cdntinker/Volt-Picker/3D/VoltPicker Case.FCStd

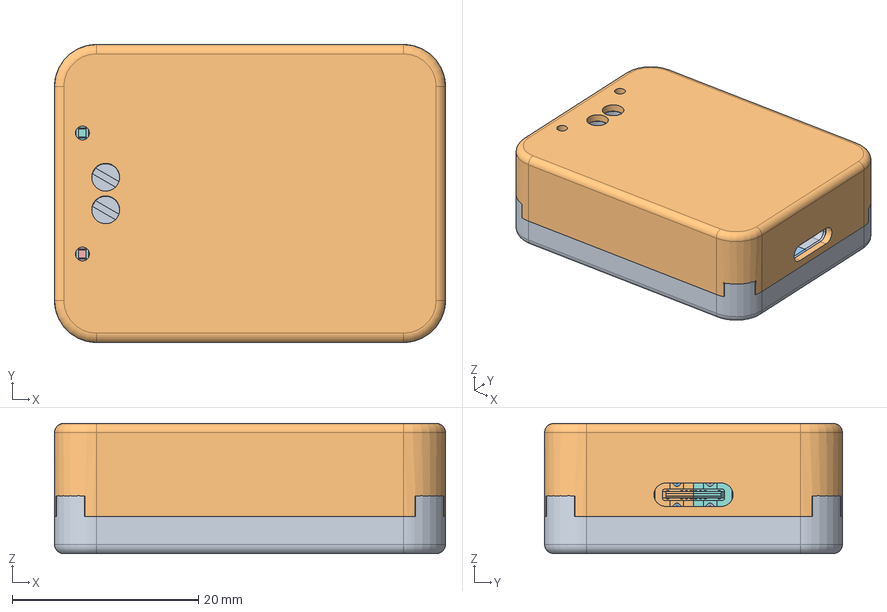
[picture p3: CAD file, 2026-10-18]
3D/VoltPicker Case.FCStd
42.0 x 32.0 x 14.0 mm
Bottom001
Top001
R_0603_1608Metric
R_0603_1608Metric001
R_1206_3216Metric
TDFN-14_L3.0-W3.0-P0.40-TL-EP.new
R_0603_1608Metric002
LED_0603_1608Metric
POWERPAK-1212-8_L3.1-W3.1-P0.65-LS3.3-BL
R_0603_1608Metric003
R_0603_1608Metric004
C_0805_2012Metric
R_0603_1608Metric005
R_0603_1608Metric006
solidBody
solidLead
solidLead001
C_0603_1608Metric
R_0603_1608Metric007
solidBody001
solidLead003
solidLead004
R_0603_1608Metric008
C_0805_2012Metric001
DG350-3.5-2P001
R_0603_1608Metric009
POWERPAK-1212-8_L3.1-W3.1-P0.65-LS3.3-BL001
R_0603_1608Metric010
R_0603_1608Metric011
R_0603_1608Metric012
R_0603_1608Metric013
USB_C_Receptacle_GCT_USB4105-xx-A_16P_TopMnt_Horizontal
USB_C_Receptacle_GCT_USB4105-xx-A_16P_TopMnt_Horizontal001
USB_C_Receptacle_GCT_USB4105-xx-A_16P_TopMnt_Horizontal002
USB_C_Receptacle_GCT_USB4105-xx-A_16P_TopMnt_Horizontal003
USB_C_Receptacle_GCT_USB4105-xx-A_16P_TopMnt_Horizontal004
USB_C_Receptacle_GCT_USB4105-xx-A_16P_TopMnt_Horizontal005
USB_C_Receptacle_GCT_USB4105-xx-A_16P_TopMnt_Horizontal006
USB_C_Receptacle_GCT_USB4105-xx-A_16P_TopMnt_Horizontal007
USB_C_Receptacle_GCT_USB4105-xx-A_16P_TopMnt_Horizontal008
USB_C_Receptacle_GCT_USB4105-xx-A_16P_TopMnt_Horizontal009
USB_C_Receptacle_GCT_USB4105-xx-A_16P_TopMnt_Horizontal010
USB_C_Receptacle_GCT_USB4105-xx-A_16P_TopMnt_Horizontal011
USB_C_Receptacle_GCT_USB4105-xx-A_16P_TopMnt_Horizontal012
USB_C_Receptacle_GCT_USB4105-xx-A_16P_TopMnt_Horizontal013
USB_C_Receptacle_GCT_USB4105-xx-A_16P_TopMnt_Horizontal014
USB_C_Receptacle_GCT_USB4105-xx-A_16P_TopMnt_Horizontal015
USB_C_Receptacle_GCT_USB4105-xx-A_16P_TopMnt_Horizontal016
USB_C_Receptacle_GCT_USB4105-xx-A_16P_TopMnt_Horizontal017
USB_C_Receptacle_GCT_USB4105-xx-A_16P_TopMnt_Horizontal018
USB_C_Receptacle_GCT_USB4105-xx-A_16P_TopMnt_Horizontal019
USB_C_Receptacle_GCT_USB4105-xx-A_16P_TopMnt_Horizontal020
USB_C_Receptacle_GCT_USB4105-xx-A_16P_TopMnt_Horizontal021
USB_C_Receptacle_GCT_USB4105-xx-A_16P_TopMnt_Horizontal022
USB_C_Receptacle_GCT_USB4105-xx-A_16P_TopMnt_Horizontal023
USB_C_Receptacle_GCT_USB4105-xx-A_16P_TopMnt_Horizontal024
USB_C_Receptacle_GCT_USB4105-xx-A_16P_TopMnt_Horizontal025
USB_C_Receptacle_GCT_USB4105-xx-A_16P_TopMnt_Horizontal026
USB_C_Receptacle_GCT_USB4105-xx-A_16P_TopMnt_Horizontal027
USB_C_Receptacle_GCT_USB4105-xx-A_16P_TopMnt_Horizontal028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
