cdntinker/Volt-Picker/Hardware/KiCAD_Customs/3D/LittleFuse-154.step

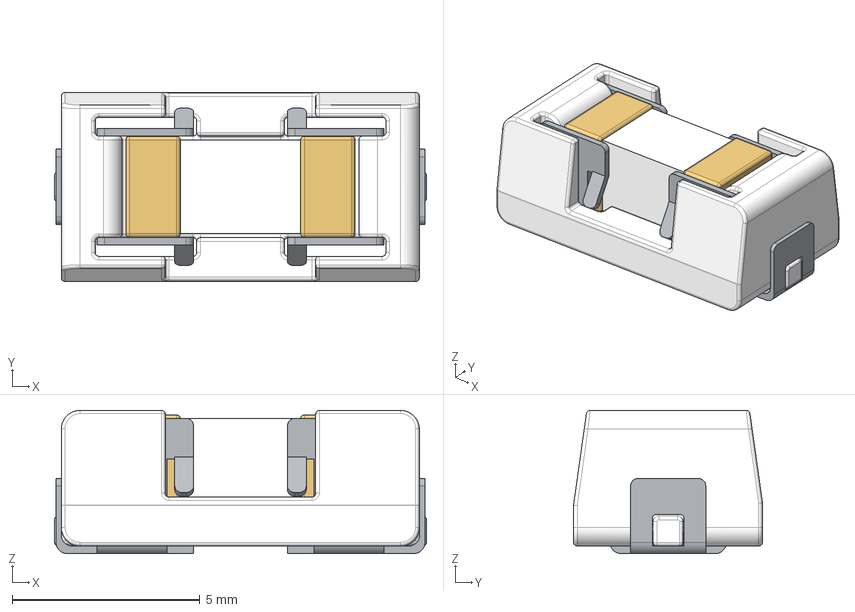
[picture p4: CAD file, 2026-10-17]
Hardware/KiCAD_Customs/3D/LittleFuse-154.step
9.90 x 5.03 x 3.81 mm
Lead2
Lead1
plastic bit
