cdntinker/Volt-Picker/Hardware/KiCAD_Customs/C24735840/TDFN-14_L3.0-W3.0-P0.40-TL-EP.step

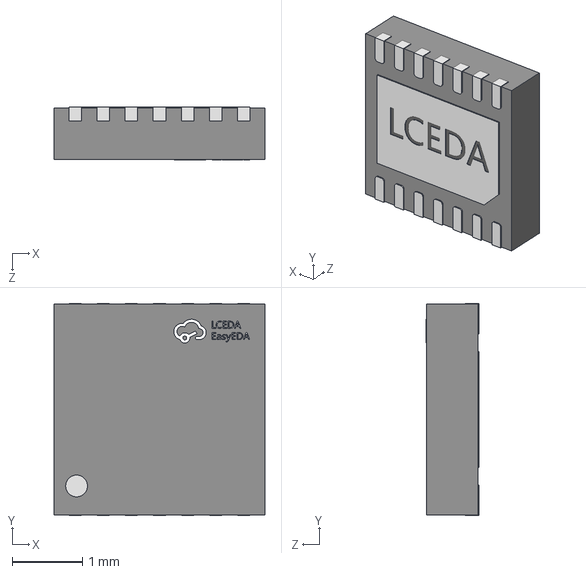
[picture p5: CAD file, 2026-10-15]
Hardware/KiCAD_Customs/C24735840/TDFN-14_L3.0-W3.0-P0.40-TL-EP.step
3.00 x 3.02 x 0.76 mm
