cdntinker/Volt-Picker/Hardware/KiCAD_Customs/C3279469/POWERPAK-1212-8_L3.1-W3.1-P0.65-LS3.3-BL.step

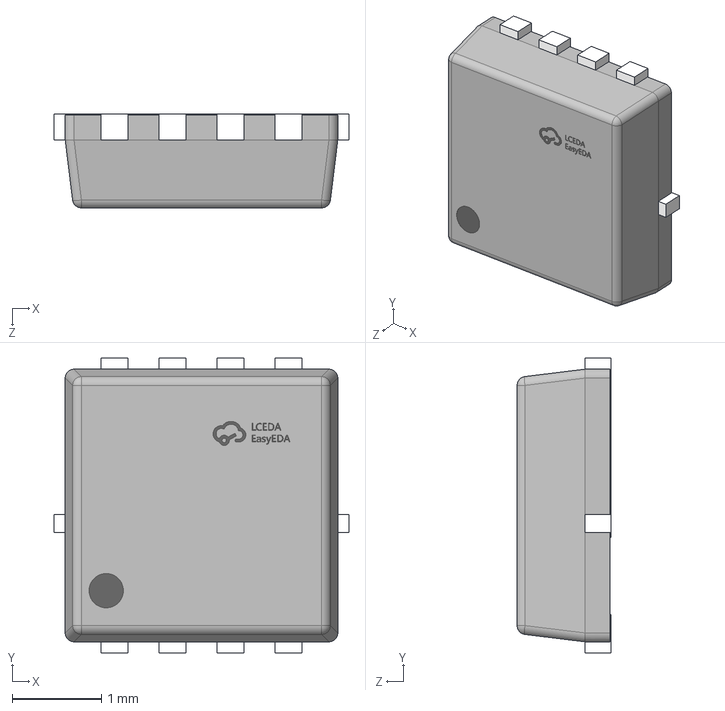
[picture p6: CAD file, 2026-10-15]
Hardware/KiCAD_Customs/C3279469/POWERPAK-1212-8_L3.1-W3.1-P0.65-LS3.3-BL.step
3.30 x 3.30 x 1.05 mm
