cdntinker/Volt-Picker/3D/Volt-Picker-300.step

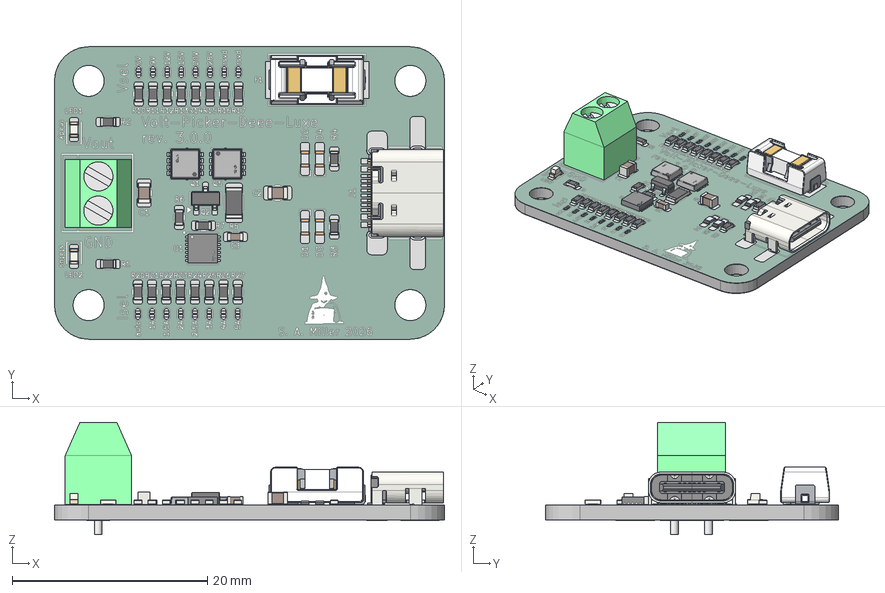
[picture p7: CAD file, 2026-10-18]
3D/Volt-Picker-300.step
40.0 x 30.0 x 11.5 mm
R_0603_1608Metric x 22
R_1206_3216Metric
TDFN-14_L3.0-W3.0-P0.40-TL-EP.new
LED_0603_1608Metric x 2
POWERPAK-1212-8_L3.1-W3.1-P0.65-LS3.3-BL x 2
C_0805_2012Metric x 2
solidBody x 4
solidLead x 4
C_0603_1608Metric
DG350-3.5-2P001
USB_C_Receptacle_GCT_USB4105-xx-A_16P_TopMnt_Horizontal
Lead2
Lead1
plastic bit
SOT-23
Volt-Picker_copper
Volt-Picker_pad
Volt-Picker_via
Volt-Picker_silkscreen
Volt-Picker_soldermask
Volt-Picker_PCB
