cdntinker/Volt-Picker/Hardware/KiCAD_Customs/3D/DG350-3.5-2P001.step

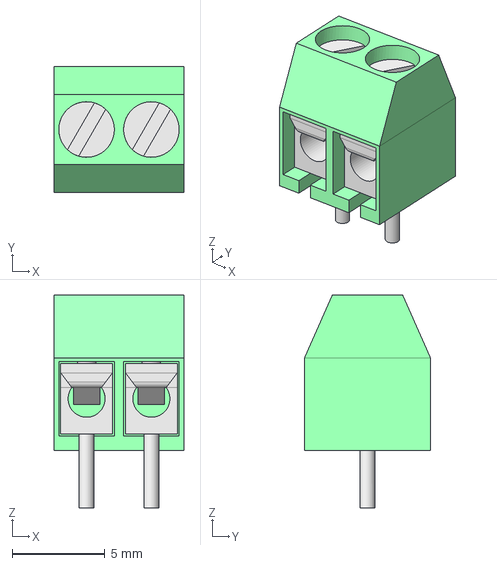
[picture p8: CAD file, 2026-10-15]
Hardware/KiCAD_Customs/3D/DG350-3.5-2P001.step
7.00 x 6.80 x 11.5 mm
