cdntinker/Volt-Picker/3D/VoltPicker Case (screwed).step

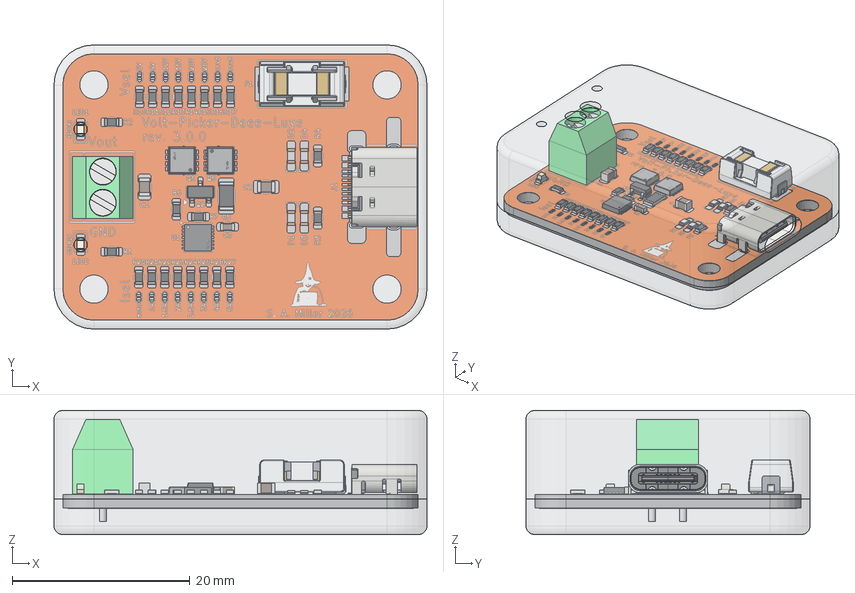
[picture p9: CAD file, 2026-10-18]
3D/VoltPicker Case (screwed).step
42.0 x 32.0 x 14.0 mm
R_0603_1608Metric x 22
R_1206_3216Metric
TDFN-14_L3.0-W3.0-P0.40-TL-EP.new
LED_0603_1608Metric x 2
POWERPAK-1212-8_L3.1-W3.1-P0.65-LS3.3-BL x 2
C_0805_2012Metric x 2
solidBody x 4
solidLead x 4
solidLead001 x 4
C_0603_1608Metric
DG350-3.5-2P001
USB_C_Receptacle_GCT_USB4105-xx-A_16P_TopMnt_Horizontal
USB_C_Receptacle_GCT_USB4105-xx-A_16P_TopMnt_Horizontal001
USB_C_Receptacle_GCT_USB4105-xx-A_16P_TopMnt_Horizontal002
USB_C_Receptacle_GCT_USB4105-xx-A_16P_TopMnt_Horizontal003
USB_C_Receptacle_GCT_USB4105-xx-A_16P_TopMnt_Horizontal004
USB_C_Receptacle_GCT_USB4105-xx-A_16P_TopMnt_Horizontal005
USB_C_Receptacle_GCT_USB4105-xx-A_16P_TopMnt_Horizontal006
USB_C_Receptacle_GCT_USB4105-xx-A_16P_TopMnt_Horizontal007
USB_C_Receptacle_GCT_USB4105-xx-A_16P_TopMnt_Horizontal008
USB_C_Receptacle_GCT_USB4105-xx-A_16P_TopMnt_Horizontal009
USB_C_Receptacle_GCT_USB4105-xx-A_16P_TopMnt_Horizontal010
USB_C_Receptacle_GCT_USB4105-xx-A_16P_TopMnt_Horizontal011
USB_C_Receptacle_GCT_USB4105-xx-A_16P_TopMnt_Horizontal012
USB_C_Receptacle_GCT_USB4105-xx-A_16P_TopMnt_Horizontal013
USB_C_Receptacle_GCT_USB4105-xx-A_16P_TopMnt_Horizontal014
USB_C_Receptacle_GCT_USB4105-xx-A_16P_TopMnt_Horizontal015
USB_C_Receptacle_GCT_USB4105-xx-A_16P_TopMnt_Horizontal016
USB_C_Receptacle_GCT_USB4105-xx-A_16P_TopMnt_Horizontal017
USB_C_Receptacle_GCT_USB4105-xx-A_16P_TopMnt_Horizontal018
USB_C_Receptacle_GCT_USB4105-xx-A_16P_TopMnt_Horizontal019
USB_C_Receptacle_GCT_USB4105-xx-A_16P_TopMnt_Horizontal020
USB_C_Receptacle_GCT_USB4105-xx-A_16P_TopMnt_Horizontal021
USB_C_Receptacle_GCT_USB4105-xx-A_16P_TopMnt_Horizontal022
USB_C_Receptacle_GCT_USB4105-xx-A_16P_TopMnt_Horizontal023
USB_C_Receptacle_GCT_USB4105-xx-A_16P_TopMnt_Horizontal024
USB_C_Receptacle_GCT_USB4105-xx-A_16P_TopMnt_Horizontal025
USB_C_Receptacle_GCT_USB4105-xx-A_16P_TopMnt_Horizontal026
USB_C_Receptacle_GCT_USB4105-xx-A_16P_TopMnt_Horizontal027
USB_C_Receptacle_GCT_USB4105-xx-A_16P_TopMnt_Horizontal028
USB_C_Receptacle_GCT_USB4105-xx-A_16P_TopMnt_Horizontal029
USB_C_Receptacle_GCT_USB4105-xx-A_16P_TopMnt_Horizontal030
USB_C_Receptacle_GCT_USB4105-xx-A_16P_TopMnt_Horizontal031
USB_C_Receptacle_GCT_USB4105-xx-A_16P_TopMnt_Horizontal032
USB_C_Receptacle_GCT_USB4105-xx-A_16P_TopMnt_Horizontal033
USB_C_Receptacle_GCT_USB4105-xx-A_16P_TopMnt_Horizontal034
USB_C_Receptacle_GCT_USB4105-xx-A_16P_TopMnt_Horizontal035
Lead2
Lead1
plastic bit
SOT-23
Volt-Picker_copper
Volt-Picker_copper001
Volt-Picker_copper002
Volt-Picker_copper003
Volt-Picker_copper004
Volt-Picker_copper005
Volt-Picker_copper006
Volt-Picker_copper007
Volt-Picker_copper008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
