cdntinker/Volt-Picker/(list of files, cad)

Other CAD files:
3D/VoltPicker Case (clipped).step
Hardware/KiCAD_Customs/3D/TDFN-14_L3.0-W3.0-P0.40-TL-EP.new.step
3D/Volt-Picker-100.step
