cdntinker/Volt-Picker/Hardware/Volt-Picker.kicad_pcb

## KiCad design Hardware/Volt-Picker.kicad_pcb (2026-10-17)

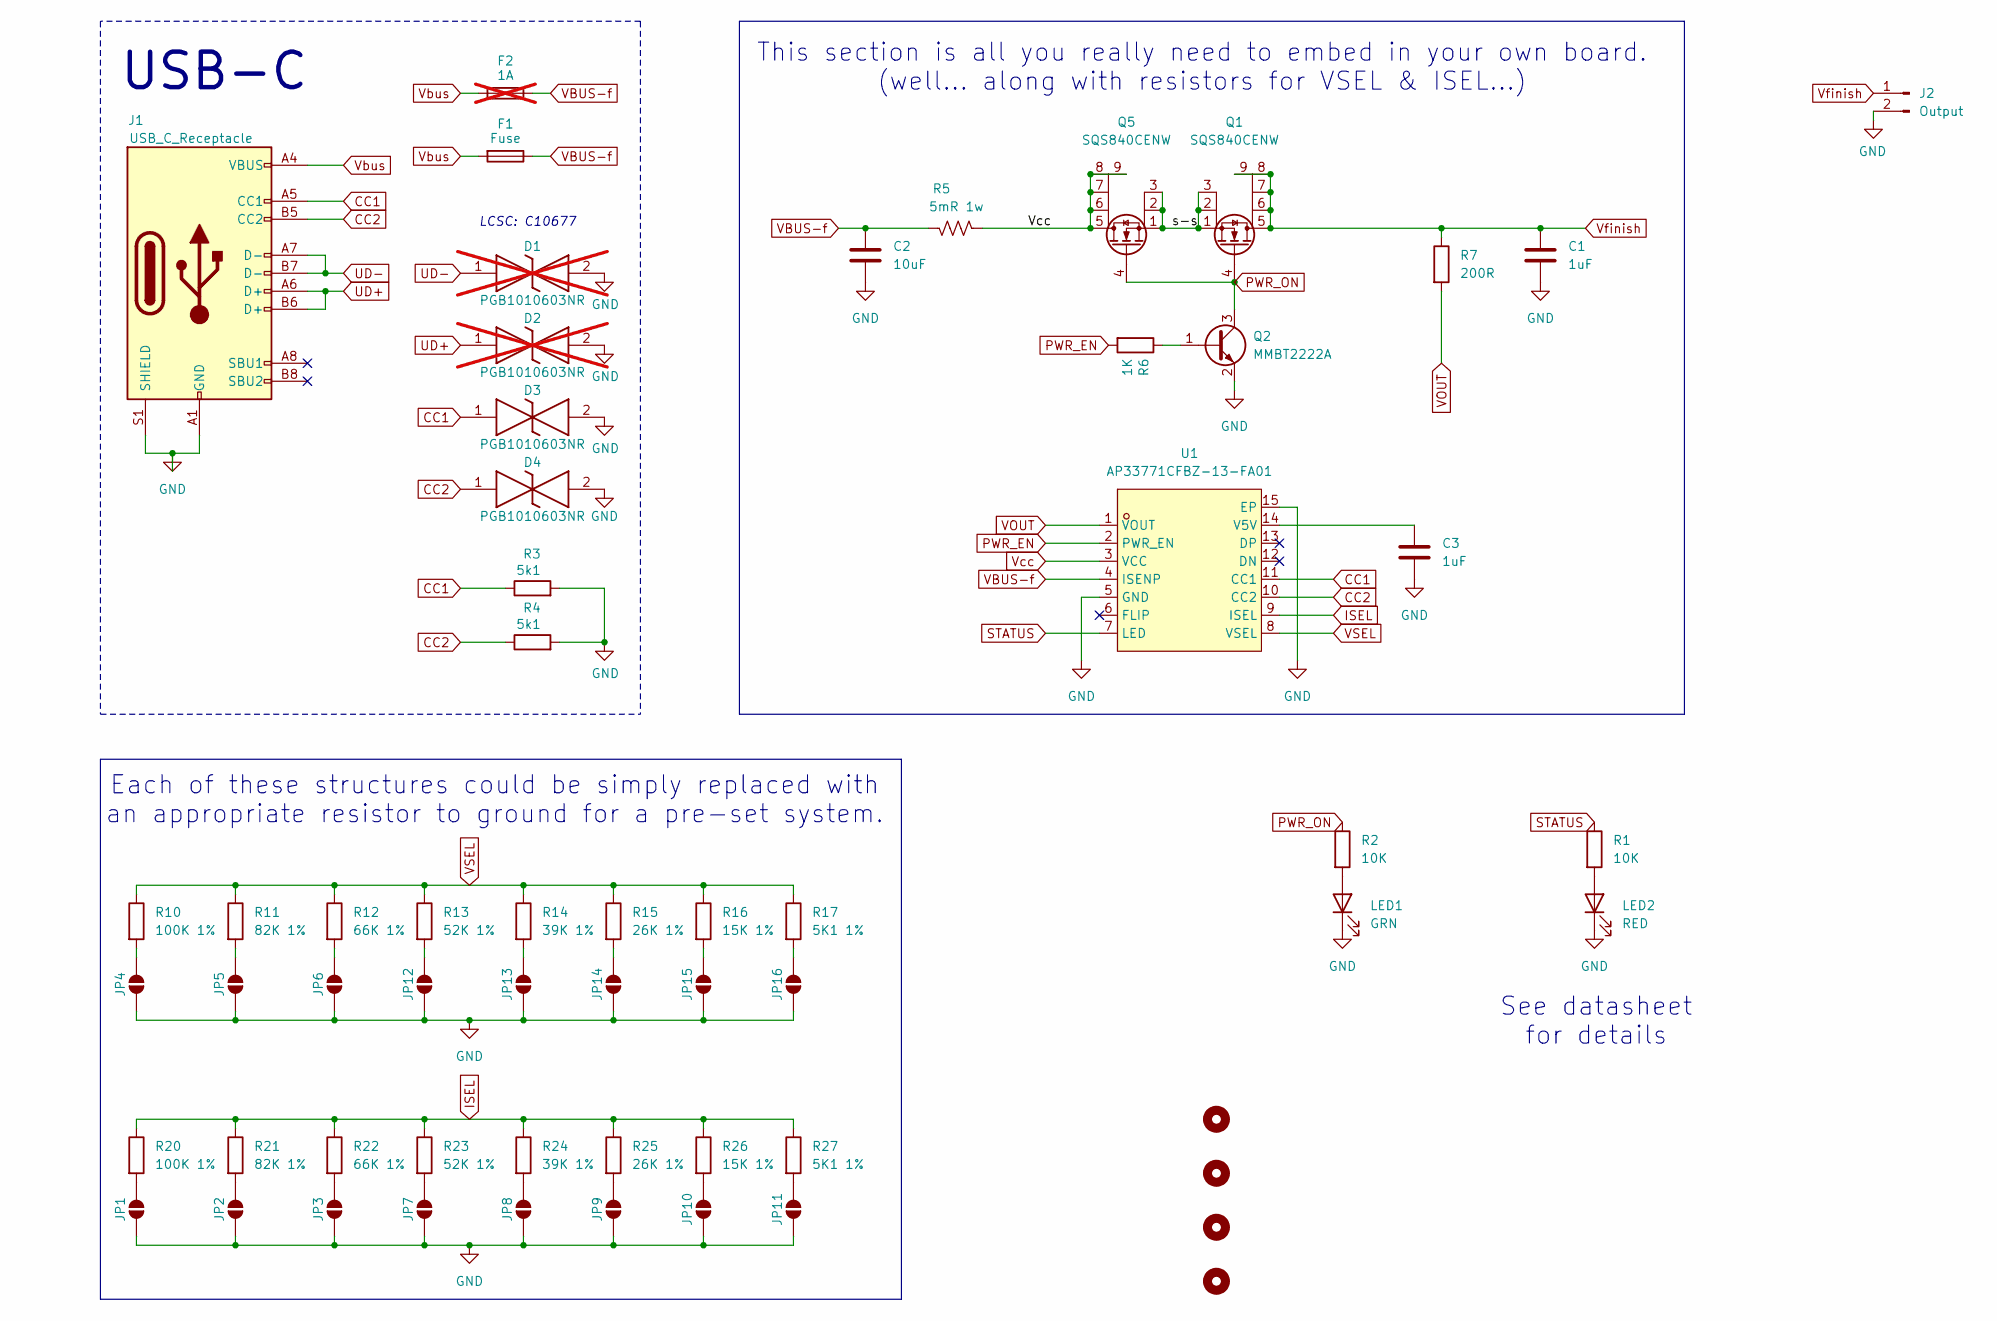
[picture p10: schematic Volt-Picker.kicad_sch, Volt-Picker-Deee-Luxe]

Parts:
C1: 1uF; C_0805_2012Metric; LCSC C28323
C2: 10uF; C_0805_2012Metric
C3: 1uF; C_0603_1608Metric; LCSC C28323
D1, D2: PGB1010603NR; PGB1010603NRHF; Manufacturer_Part_Number PGB1010603NR; Mouser Part Number 576-PGB1010603NR; not fitted
D3, D4: PGB1010603NR; PGB1010603NRHF; Manufacturer_Part_Number PGB1010603NR; Mouser Part Number 576-PGB1010603NR
F1: Fuse; Fuseholder_Littelfuse_Nano2_154x; LCSC Part C206922 (maybe)
F2: 1A; Fuse_1206_3216Metric_Pad1.42x1.75mm_HandSolder; LCSC C41367221; not fitted
H1, H2, H3, H4: MountingHole; MountingHole_3.2mm_M3_DIN965
J1: USB_C_Receptacle; USB_C_Receptacle_HRO_TYPE-C-31-M-12; LCSC C2765186
J2: Output; TerminalBlock_DG350-3.5-02P-14-00A(H); LCSC C2760668
JP1, JP2, JP3, JP4, JP5, JP6, JP7, JP8, JP9, JP10, JP11, JP12, JP13, JP14, JP15, JP16: SolderJumper_2_Open; tinySJ-Open (alt)
LED1: GRN; LED_0603_1608Metric; LCSC C2994781
LED2: RED; LED_0603_1608Metric; LCSC C2994781
Q1, Q5: SQS840CENW; POWERPAK-1212-8_L3.1-W3.1-P0.65-LS3.3-BL
Q2: MMBT2222A; SOT-23; LCSC Part C916372
R1, R2: 10K; R_0603_1608Metric
R3, R4: 5k1; R_0603_1608Metric; LCSC C23186
R5: 5mR 1w; R_1206_3216Metric
R6: 1K; R_0603_1608Metric; LCSC Part C22548
R7: 200R; R_0603_1608Metric
R10, R20: 100K 1%; R_0603_1608Metric
R11, R21: 82K 1%; R_0603_1608Metric
R12, R22: 66K 1%; R_0603_1608Metric
R13, R23: 52K 1%; R_0603_1608Metric
R14, R24: 39K 1%; R_0603_1608Metric
R15, R25: 26K 1%; R_0603_1608Metric
R16, R26: 15K 1%; R_0603_1608Metric
R17, R27: 5K1 1%; R_0603_1608Metric
U1: AP33771CFBZ-13-FA01; TDFN-14_L3.0-W3.0-P0.40-TL-EP; MPN AP33771CFBZ-13-FA01; LCSC Part C24735840

Connections:
/s-s: Q1.1 (S), Q1.2 (S), Q1.3 (S), Q5.1 (S), Q5.2 (S), Q5.3 (S)
CC1: D3.1, J1.A5 (CC1), R3.1, U1.11 (CC1)
CC2: D4.1, J1.B5 (CC2), R4.1, U1.10 (CC2)
GND: C1.2, C2.2, C3.2, D1.2, D2.2, D3.2, D4.2, J1.A1 (GND), J1.A12 (GND), J1.B1 (GND), J1.B12 (GND), J1.S1 (SHIELD), J2.2, JP1.1 (A), JP2.1 (A), JP3.1 (A), JP4.1 (A), JP5.1 (A), JP6.1 (A), JP7.1 (A), JP8.1 (A), JP9.1 (A), JP10.1 (A), JP11.1 (A), JP12.1 (A), JP13.1 (A), JP14.1 (A), JP15.1 (A), JP16.1 (A), LED1.1 (K), LED2.1 (K), Q2.2 (E), R3.2, R4.2, U1.5 (GND), U1.15 (EP)
ISEL: R20.1, R21.1, R22.1, R23.1, R24.1, R25.1, R26.1, R27.1, U1.9 (ISEL)
unnamed: JP1.2 (B), R20.2
unnamed: JP2.2 (B), R21.2
unnamed: JP3.2 (B), R22.2
unnamed: JP4.2 (B), R10.2
unnamed: JP5.2 (B), R11.2
unnamed: JP6.2 (B), R12.2
unnamed: JP7.2 (B), R23.2
unnamed: JP8.2 (B), R24.2
unnamed: JP9.2 (B), R25.2
unnamed: JP10.2 (B), R26.2
unnamed: JP11.2 (B), R27.2
unnamed: JP12.2 (B), R13.2
unnamed: JP13.2 (B), R14.2
unnamed: JP14.2 (B), R15.2
unnamed: JP15.2 (B), R16.2
unnamed: JP16.2 (B), R17.2
unnamed: LED1.2 (A), R2.2
unnamed: LED2.2 (A), R1.2
unnamed: Q2.1 (B), R6.1
unnamed: C3.1, U1.14 (V5V)
PWR_EN: R6.2, U1.2 (PWR_EN)
PWR_ON: Q1.4 (G), Q2.3 (C), Q5.4 (G), R2.1
STATUS: R1.1, U1.7 (LED)
UD+: D2.1, J1.A6 (D+), J1.B6 (D+)
UD-: D1.1, J1.A7 (D-), J1.B7 (D-)
VBUS-f: C2.1, F1.1, F2.2, R5.2, U1.4 (ISENP)
VOUT: R7.2, U1.1 (VOUT)
VSEL: R10.1, R11.1, R12.1, R13.1, R14.1, R15.1, R16.1, R17.1, U1.8 (VSEL)
Vbus: F1.2, F2.1, J1.A4 (VBUS), J1.A9 (VBUS), J1.B4 (VBUS), J1.B9 (VBUS)
Vcc: Q5.5 (D), Q5.6 (D), Q5.7 (D), Q5.8 (D), Q5.9 (D), R5.1, U1.3 (VCC)
Vfinish: C1.1, J2.1, Q1.5 (D), Q1.6 (D), Q1.7 (D), Q1.8 (D), Q1.9 (D), R7.1

Notes on the sheet:
USB-C
Each of these structures could be simply replaced with an appropriate resistor to ground for a pre-set system.
LCSC: C10677
See datasheet for details
This section is all you really need to embed in your own board. (well... along with resistors for VSEL & ISEL...)

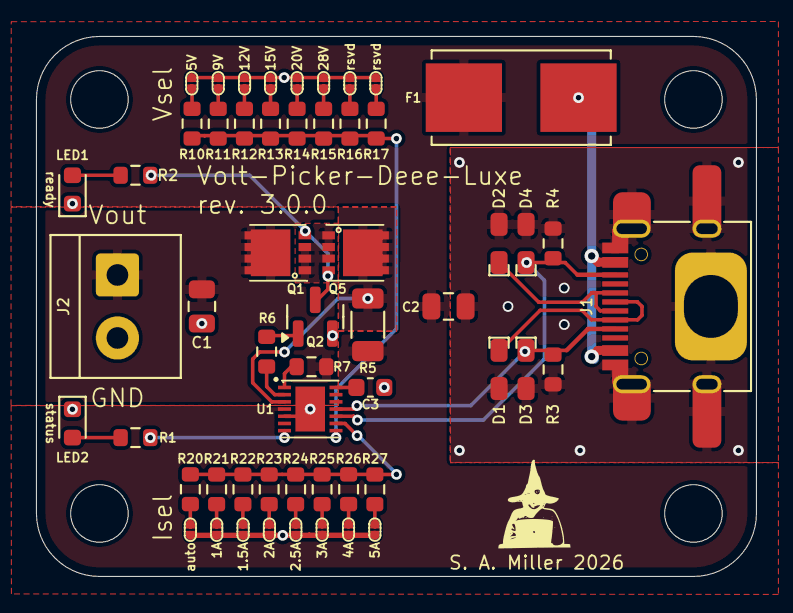
[picture p11: board Volt-Picker.kicad_pcb from above]

Board: 2 copper layers, 40.0 x 30.0 mm, 59 parts (0 on the bottom side), 36 nets.
