cdntinker/Volt-Picker/(commit log)

2026-10-10 Case design rabbit hole...
    [USB-PD Experiments 1.step, USB-PD Experiments.step, VoltPicker Case.FCStd, VoltPicker Case.step]
2026-10-11 case tweakin'
    [VoltPicker Case.FCStd]
2026-10-15 Total rework to rev 3.0.0
    [DG350-3.5-2P001.step, POWERPAK-1212-8_L3.1-W3.1-P0.65-LS3.3-BL.step, TDFN-14_L3.0-W3.0-P0.40-TL-EP.new.step, TDFN-14_L3.0-W3.0-P0.40-TL-EP.step, USB-PD Experiments.kicad_pcb, USB-PD Experiments.kicad_sch, USB-PD Experiments.step, Unnamed1-TDFN-14_L3.0-W3.0-P0.40-TL-EP.step]
2026-10-15 fixed a tiny oops...
    [Volt-Picker.kicad_pcb]
2026-10-15 repo cleanup
    [USB-PD Experiments-B_Cu.gbr, USB-PD Experiments-B_Mask.gbr, USB-PD Experiments-B_Paste.gbr, USB-PD Experiments-B_Silkscreen.gbr, USB-PD Experiments-Edge_Cuts.gbr, USB-PD Experiments-F_Cu.gbr, USB-PD Experiments-F_Mask.gbr, USB-PD Experiments-F_Paste.gbr]
2026-10-15 messin' about with the case...
    [USB-PD Experiments.step, Unnamed1-TDFN-14_L3.0-W3.0-P0.40-TL-EP.step, Volt-Picker-100.step, Volt-Picker-300.step, VoltPicker Case (clipped).step, VoltPicker Case (screwed).step, VoltPicker Case.FCStd, VoltPicker Case.step]
2026-10-17 Tweakin' & Squishin'
    [Volt-Picker.kicad_pcb, Volt-Picker.kicad_sch]
2026-10-17 One day... I'll stop tweakin'
    [LittleFuse-154.step, Volt-Picker.kicad_pcb, Volt-Picker.kicad_sch]
2026-10-17 moar tweakin'
    [Volt-Picker.kicad_pcb]
2026-10-18 re-doing 3D for rev 3.0.0
    [Volt-Picker-300.step, VoltPicker Case (clipped).step, VoltPicker Case (screwed).step, VoltPicker Case.FCStd, WTF-2.step, WTF.FCStd, WTF.step]
